aluzeita1590/gemelo-digital-aceite-oliva/README.md

# Gemelo Digital — Tanque de Almacenamiento de Aceite de Oliva

**Trabajo de Titulación — Ingeniería Civil Electrónica, UACh**  
Autor: Sebastián Araneda

---

## Descripción

Sistema de gemelo digital para un tanque prototipo de 20 L de aceite de oliva,
organizado en una arquitectura de 4 capas escalable a los tanques industriales
de 50.000 L de Las 200.

El sistema estima en tiempo real la distribución espacial de temperatura T(r,z,t),
nivel y masa del aceite, a partir de las temperaturas medidas en la pared exterior
del tanque. Los resultados se visualizan en un dashboard Grafana y un heatmap 2D
generado por el modelo.

---

## Arquitectura del sistema

**Capa 1 — Raspberry Pi `sensor` (192.168.1.106)**
- 5× DS18B20 en pared exterior (DS0–DS4), 2× DS18B20 ambiente (DS_AMB1, DS_AMB2), 1× DS18B20 tanque superior (DS_SUP), 1x DS18B20 interir (DS_INT)
- HC-SR04 (nivel), HX711 + celda de carga (masa), Display OLED
- Publica JSON por MQTT cada 10 segundos al broker en `gemelo5`
- Corre como `sensor.service` (systemd)

**Capa 2 — Raspberry Pi `gemelo5` (192.168.1.104)**
- Broker Mosquitto recibe los mensajes MQTT
- Suscriptor Python valida rangos físicos y escribe en InfluxDB bucket `gemelo`
- Corre como `suscriptor.service` (systemd)

**Capa 3 — Raspberry Pi `gemelo5`**
- Modelo 2D axisimétrico T(r,z,t) en tiempo real
- Lee temperaturas de pared desde InfluxDB, estima la distribución interior del fluido
- Sirve heatmap PNG en puerto 5000 via Flask
- Corre como `modelo.service` (systemd)

**Capa 4 — Raspberry Pi `gemelo5`**
- Dashboard Grafana conectado a InfluxDB
- Kiosco en monitor conectado a la Pi 5

> La Raspberry Pi `gemelo5` es el servidor provisional.
> La migración a servidor de la UACh (con Docker) está planificada.

---

## Hardware (Prototipo)

| Componente | Función | Capa |
|---|---|---|
| Raspberry Pi Zero 2 W (`sensor`) | Adquisición de datos | 1 |
| Raspberry Pi 5 (`gemelo5`) | Servidor provisional | 2, 3, 4 |
| 5× DS18B20 (DS0–DS4) | Temperatura pared exterior (0–30 cm) | 1 |
| 2× DS18B20 (DS_AMB1, DS_AMB2) | Temperatura ambiente (promediadas) | 1 |
| 1× DS18B20 (DS_SUP) | Temperatura fluido tanque superior | 1 |
| 1× DS18B20 (DS_INT) | Temperatura interior del fluido — encapsulado sumergible, posicionado en r=0, z=20.1 cm | 1 |
| HC-SR04 | Nivel ultrasónico | 1 |
| HX711 + celda de carga | Masa | 1 |
| Display OLED 128×64 I2C | Visualización local | 1 |
| 2× YF-S021 | Caudal y volumen acumulado (entrada y salida) | 1 |

---

## Estructura del repositorio

```
gemelo-digital-aceite-oliva/
├── config.py                          # Configuración central (único lugar para cambiar parámetros)
├── .env                               # Token InfluxDB — (ver .env.example)
├── .env.example                       # Plantilla del .env
│
├── capa1_sensor/
│   ├── sensor.py                      # Script en producción — RPi Zero 2W
│   └── calibrar_flujo.py              # Calibración de sensores YF-S021
│
├── capa2_adquisicion/
│   ├── suscriptor.py                  # Script en producción — RPi 5
│   └── telegraf.conf                  # Pipeline alternativo (Telegraf)
│
├── capa3_modelo/
│   ├── modelo.py                      # Script en producción — RPi 5
│   ├── calibrar_h_ext.py              # Calibración offline del coeficiente h_ext
│   ├── resultados_calibracion/        # Gráficas generadas por calibrar_h_ext.py
│   ├── tanque_modelo_2D_v2.py         # Referencia — modelo standalone v2.1
│   └── tanque_modelo_2D_v3.py         # Referencia — modelo standalone v3.0
│
└── docker/
    ├── docker-compose.yml             # Orquestación (preparado, pendiente de despliegue)
    ├── grafana/
    │   └── telegraf-dashboard.json    # Dashboard Grafana importable — pipeline Telegraf
    ├── modelo/
    │   ├── Dockerfile                 # Imagen del modelo (usa capa3_modelo/modelo.py)
    │   └── requirements.txt
    ├── suscriptor/
    │   ├── Dockerfile                 # Imagen del suscriptor
    │   └── requirements.txt
    └── mosquitto/
        └── config/mosquitto.conf
```

---

## Configuración centralizada

Todos los parámetros del sistema están en **`config.py`** en la raíz del repositorio.
No es necesario modificar los scripts para cambiar IPs, topics, IDs de sensores o parámetros del modelo.

```python
# Ejemplos de parámetros en config.py
MQTT_BROKER_SENSOR = "192.168.1.104"   # IP del gemelo (usado por sensor)
MODELO_IC_DEFAULT  = "t_sup"           # Condición inicial al arrancar: "t_sup" | "sensores"
MODELO_ALPHA_K     = 0.6               # Ganancia asimilación de datos
```

```bash
# .env
INFLUX_TOKEN=your_influxdb_token_here
```

Crear a partir de la plantilla:
```bash
cp .env.example .env
# editar .env con el token real
```

En producción, systemd lo carga via `EnvironmentFile=/home/sebar/.env` en el override de cada servicio.
En Docker, lo inyecta `env_file: ../.env` en el `docker-compose.yml`.

---

## Modelo termofísico (Capa 3)

El modelo resuelve la **ecuación de calor en coordenadas cilíndricas** para un fluido estático:

```
ρ(T)·Cp·∂T/∂t = k·[1/r·∂/∂r(r·∂T/∂r) + ∂²T/∂z²]
```

A partir de las temperaturas medidas en la pared (DS0–DS4), estima T(r,z) en el interior del fluido.
En cada ciclo los nodos de pared se corrigen hacia las mediciones reales (asimilación de datos).

### Condiciones de contorno

| Borde | Condición |
|---|---|
| r = 0 | Simetría axial (L'Hôpital) |
| r = R | Robin + corrección por asimilación de datos (DS0–DS4) |
| z = 0 | Fondo adiabático |
| z = H | Superficie libre adiabática |

### Parámetros del modelo

| Parámetro | Valor | Descripción |
|---|---|---|
| Nr × Nz | 15 × 20 | Nodos radiales × axiales |
| dt | ≤ 30 s | Paso temporal (Von Neumann estable) |
| h_ext | 5.0 W/(m²·°C) | Convección exterior — pendiente calibración |
| alpha_K | 0.6 | Ganancia asimilación de datos |
| IC default | `t_sup` | Condición inicial al arrancar el servicio |
| `TANQUE_PARED_ESPESOR_M` | 0.003 m | Espesor de pared — prototipo HDPE 3 mm |
| `TANQUE_PARED_K` | 0.45 W/(m·°C) | Conductividad pared — HDPE (acero inox: 16) |

La resistencia térmica de la pared se incorpora en la condición Robin mediante el coeficiente global `U`:

```
1/U = e_pared/k_pared + 1/h_ext
```

Para el tanque industrial (acero inoxidable) cambiar en `config.py`:
```python
TANQUE_PARED_ESPESOR_M = 0.005   # [m]
TANQUE_PARED_K         = 16.0    # [W/(m·°C)]
```

### Propiedades del aceite (Ribeiro et al. 2017, Fasina y Colley 2008)

- ρ(T) = 912.66 − 0.0803·T [kg/m³] — densidad variable
- Cp = 1970 J/(kg·°C)
- k = 0.17 W/(m·°C)
- Válido para T ∈ [10°C, 40°C]

### Propiedades del agua (valores estándar a 20°C)

- ρ(T) = 998.2 − 0.0975·T [kg/m³] — densidad variable (linealización local)
- Cp = 4182 J/(kg·°C)
- k = 0.598 W/(m·°C)

El fluido activo se selecciona en tiempo real con el comando MQTT `fluido/aceite` o `fluido/agua` (ver sección Comandos MQTT). Al cambiar de fluido el modelo recalcula el paso temporal `dt` para mantener la estabilidad de Von Neumann.

La selección se persiste en `capa3_modelo/.fluido_estado.json` (no versionado) cada vez que se recibe el comando. Al arrancar, `modelo.py` restaura el último fluido guardado en vez de usar siempre `MODELO_FLUIDO_DEFAULT` de `config.py` — así un reinicio del servicio (crash, `git pull`, reboot) no revierte silenciosamente una prueba en curso con agua al default de aceite.

### Versiones de referencia (archivos standalone)

| Versión | Grilla | Laplaciano | Archivo |
|---|---|---|---|
| v2.1 | Nr=3, Nz=7 | Loops Python | `tanque_modelo_2D_v2.py` |
| v3.0 | Nr=15, Nz=20 | Vectorizado NumPy (~50× más rápido) | `tanque_modelo_2D_v3.py` |

### Geometría real del tanque

El tanque prototipo no es un cilindro perfecto — el radio interno crece linealmente desde la base hasta la tapa (frustum cónico). El solver térmico usa el radio nominal `TANQUE_R_M` como aproximación, pero el cálculo de volumen y masa usa la geometría real medida:

| Altura | Diámetro medido | Radio |
|---|---|---|
| 3.8 cm (base) | 26.6 cm | 0.133 m |
| 19.0 cm (mitad) | 27.8 cm | 0.139 m |
| 38.0 cm (tapa) | 28.9 cm | 0.1445 m |

La altura total medida es **38.2 cm** (`TANQUE_H_M = 0.382` en `config.py`), usada tanto por el modelo como por el HC-SR04 para calcular el nivel.

El radio real `R(z)` se interpola linealmente entre estos puntos mediante `TANQUE_R_MEDICIONES_Z_M` y `TANQUE_R_MEDICIONES_R_M` en `config.py`.

### Cálculo de volumen y masa

En cada ciclo el modelo estima el volumen y la masa del fluido usando tres métodos complementarios:

**V_nivel** — desde el sensor HC-SR04, integrando la sección real A(z) = π·R(z)²:
```
V_nivel = Σ π·R(z_j)²·dz   para z_j ≤ h_medido
```

**V_modelo / M_modelo** — integración nodo a nodo del campo de densidad ρ(r,z):
```
dV(i,j) = 2π·r_local·dr_j·dz      (anillo)
dV(0,j) = π·(dr_j/2)²·dz          (eje central)
dM(i,j) = ρ(i,j)·dV(i,j)
```
Donde `r_local = i·dr_j` y `dr_j = R(z_j)/(Nr-1)` usan el radio real en cada altura.

**M_HX711** — masa medida directamente por la celda de carga.

**V_balance** — balance de masa usando los sensores de flujo como referencia independiente:
```
V_balance(t) = V_nivel(t₀) + ΔV_entrada(t) − ΔV_salida(t)
```
Donde `t₀` es el instante de arranque del modelo y `ΔV` es el volumen acumulado desde ese momento según cada YF-S021. Sirve como validación cruzada entre el HC-SR04 y los sensores de flujo.

Los resultados se escriben en InfluxDB como measurement `volumen_masa` cada 60 segundos con campos `V_nivel_L`, `V_modelo_L`, `V_balance_L`, `M_hx711_kg` y `M_modelo_kg`. También se muestran en el heatmap como cuadro de texto en la esquina inferior izquierda.

### Validación interior del modelo

El sensor **DS_INT** (DS18B20 con encapsulado sumergible) está posicionado en el interior del fluido en r=0 (eje central), z=20.1 cm, coincidiendo exactamente con el nodo del modelo `T[0, Nz//2]` (z[10] con H=38.2 cm, Nz=20, dz=2.01 cm).

En cada ciclo de 60 segundos el modelo escribe el measurement `validacion_interior` en InfluxDB con los campos:

| Campo | Descripción |
|---|---|
| `T_medida_C` | Temperatura medida por DS_INT [°C] |
| `T_modelo_C` | Temperatura estimada por el modelo en nodo (r=0, z≈20.1 cm) [°C] |
| `error_C` | Diferencia T_modelo − T_medida [°C] |
| `nodo_z_cm` | Posición axial del nodo de comparación [cm] |

Además de la variante nominal (`alpha_K`), el mismo punto incluye `T_alta_C`/`error_alta_C` (α=0,80), `T_baja_C`/`error_baja_C` (α=0,20) y `T_libre_C`/`error_libre_C` (α=0, sin asimilación) — variantes con heatmap propio (`/heatmap_alta`, `/heatmap_baja`, `/heatmap_libre`) que corren en paralelo para comparación. También se agregaron tres variantes exploratorias sin heatmap propio, solo para acotar el óptimo de `alpha_K` encontrado en el Capítulo 5 de la tesis (vértice≈0,36): `T_a30_C`/`error_a30_C` (α=0,30), `T_a35_C`/`error_a35_C` (α=0,35) y `T_a40_C`/`error_a40_C` (α=0,40).

El heatmap muestra un **punto cian** en la posición del sensor y los valores T int med / T int mod / Error int en el cuadro inferior.

Con la corrección geométrica, la diferencia entre V_nivel y V_modelo se redujo de 14% a ~7%.

#### Métricas de error: MAE y RMSE

Las métricas se calculan sobre la ventana temporal seleccionada en Grafana mediante queries Flux al measurement `validacion_interior`.

**Definiciones:**

$$\text{MAE} = \frac{1}{N} \sum_{k=1}^{N} |e_k|$$

$$\text{RMSE} = \sqrt{\frac{1}{N} \sum_{k=1}^{N} e_k^2}$$

donde $e_k = T_{\text{modelo},k} - T_{\text{medida},k}$ es el error en el instante $k$ y $N$ es el número de muestras en la ventana. El RMSE penaliza más los errores grandes (por el cuadrado), por lo que RMSE ≥ MAE siempre. La hipótesis de validación de la tesis establece RMSE < 1 °C.

**Query MAE (Flux):**
```flux
import "math"
from(bucket: "gemelo")
  |> range(start: v.timeRangeStart, stop: v.timeRangeStop)
  |> filter(fn: (r) => r._measurement == "validacion_interior")
  |> filter(fn: (r) => r._field == "error_C")
  |> map(fn: (r) => ({r with _value: math.abs(x: r._value)}))
  |> mean()
  |> yield(name: "MAE")
```

**Query RMSE (Flux):**
```flux
import "math"
from(bucket: "gemelo")
  |> range(start: v.timeRangeStart, stop: v.timeRangeStop)
  |> filter(fn: (r) => r._measurement == "validacion_interior")
  |> filter(fn: (r) => r._field == "error_C")
  |> map(fn: (r) => ({r with _value: r._value * r._value}))
  |> mean()
  |> map(fn: (r) => ({r with _value: math.sqrt(x: r._value)}))
  |> yield(name: "RMSE")
```

Estos queries están implementados en el dashboard **Gemelo Digital — Validación Interior** (`docker/grafana/validacion-interior-dashboard.json`), que se puede importar en Grafana desde Dashboards → Import → Upload JSON file.

> **Nota de arranque:** al reiniciar el sistema, siempre detener/reiniciar primero `sensor.service` y esperar ~30 segundos antes de reiniciar `modelo.service`. Si ambos se reinician simultáneamente, el sensor resetea sus contadores de volumen a 0 pero InfluxDB aún conserva los valores anteriores — esto hace que V_balance calcule un delta incorrecto al arrancar.

### Visualización del heatmap

El heatmap en `http://192.168.1.104:5000/heatmap` muestra:
- **Mapa de color** `plasma` con la distribución T(r,z)
- **Barra derecha** — escala de temperatura [°C]
- **Barra izquierda** — escala de densidad ρ [kg/m³] (colormap `plasma_r`)
- **Punto cian** — posición del sensor DS_INT en el interior del fluido (r=0, z≈20 cm)
- **Cuadro inferior** — valores de volumen, masa y validación interior (T int med / T int mod / Error int) en tiempo real

### Limitación conocida

Ra ≈ 1.4×10⁶ indica que la convección natural es significativa. El modelo asume fluido estático (conducción pura). Incorporar convección natural queda propuesto como trabajo futuro.

---

## Configuración de red

| Dispositivo | IP | Red |
|---|---|---|
| Raspberry `sensor` | 192.168.1.106 | wifi_control.iee |
| Raspberry `gemelo5` | 192.168.1.104 | wifi_control.iee |

| Servicio | URL |
|---|-----|
| Grafana dashboard | http://192.168.1.104:3000 |
| Heatmap modelo | http://192.168.1.104:5000/heatmap |
| InfluxDB | http://192.168.1.104:8086 |

---

## Pines físicos (Raspberry Pi Zero 2 W)

| Sensor | Pin físico | GPIO BCM |
|---|---|---|
| DS18B20 DATA (todos) | 7 | GPIO 4 |
| HC-SR04 TRIG | 18 | GPIO 24 |
| HC-SR04 ECHO | 22 | GPIO 25 |
| HX711 DT | 21 | GPIO 9 |
| HX711 SCK | 23 | GPIO 11 |
| OLED SDA | 3 | GPIO 2 |
| OLED SCL | 5 | GPIO 3 |
| Relé bomba (IN) | 40 | GPIO 21 |
| YF-S021 entrada | 13 | GPIO 27 |
| YF-S021 salida  | 15 | GPIO 22 |

---

## Despliegue en producción (systemd)

Los scripts corren como servicios systemd en sus respectivas RPis.

### Rutas en producción

Ambas RPis tienen el repositorio clonado en `~/gemelo-digital-aceite-oliva/`. Los servicios systemd apuntan directamente a esas rutas.

| Script | Ruta en RPi |
|---|---|
| `sensor.py` | `/home/sebar/gemelo-digital-aceite-oliva/capa1_sensor/sensor.py` (RPi Zero) |
| `suscriptor.py` | `/home/sebar/gemelo-digital-aceite-oliva/capa2_adquisicion/suscriptor.py` (RPi 5) |
| `modelo.py` | `/home/sebar/gemelo-digital-aceite-oliva/capa3_modelo/modelo.py` (RPi 5) |
| `config.py` | `/home/sebar/gemelo-digital-aceite-oliva/config.py` (ambas RPis) |
| `.env` | `/home/sebar/.env` (RPi 5) |

## Monitoreo de servicios

### Ver estado

```bash
sudo systemctl status sensor        # RPi Zero
sudo systemctl status suscriptor    # RPi 5
sudo systemctl status modelo        # RPi 5
sudo systemctl status telegraf      # RPi 5
```

### Ver logs en tiempo real

```bash
sudo journalctl -u sensor -f
sudo journalctl -u suscriptor -f
sudo journalctl -u modelo -f
sudo journalctl -u telegraf -f
```

### Reiniciar un servicio

```bash
sudo systemctl restart modelo
```

### Ver últimas líneas del log

```bash
sudo journalctl -u modelo -n 50
```

---

## Pipeline de datos

Existen dos pipelines paralelos activos que escriben en buckets separados de InfluxDB:

### Pipeline A — Suscriptor Python (`gemelo`)

```
Sensor → MQTT → suscriptor.py → InfluxDB (bucket: gemelo)
                                        ↑
modelo.py ──────────────────────────────┘  (escribe directo)
```

- Valida rangos físicos antes de escribir (descarta lecturas fuera de rango)
- Normaliza los datos en measurements separados: `temperatura`, `nivel`, `masa`, `flujo`, `bomba`
- El modelo termofísico escribe sus resultados (`temperatura_modelo`, `modelo_estado`) **directamente** en este bucket, sin pasar por MQTT
- Corre como `suscriptor.service` (systemd)
- **Dashboard Grafana principal** — incluye heatmap y datos del modelo

### Pipeline B — Telegraf (`gemelo_telegraf`)

```
Sensor → MQTT → Telegraf → InfluxDB (bucket: gemelo_telegraf)

modelo.py → InfluxDB (gemelo)   ← Telegraf NO tiene acceso
```

- Sin validación de rangos físicos
- Todos los campos en un único measurement: `mqtt_consumer`
- También recolecta métricas del sistema de la RPi 5: `cpu`, `mem`, `disk`, `temp`
- Configuración: `capa2_adquisicion/telegraf.conf` → copiado en `/etc/telegraf/telegraf.conf`
- Corre como `telegraf.service` (systemd)
- **Dashboard Grafana secundario** — datos del sensor + métricas del sistema RPi 5
- Dashboard importable disponible en `docker/grafana/telegraf-dashboard.json` (Grafana → Dashboards → Import)

### ¿Por qué dos dashboards?

El modelo termofísico escribe sus resultados directamente en InfluxDB (bucket `gemelo`), **no publica por MQTT**. Por lo tanto Telegraf nunca los ve y el dashboard de Telegraf no puede mostrar el heatmap ni los datos del modelo. Ambos pipelines son complementarios:

| | `gemelo` | `gemelo_telegraf` |
|---|---|---|
| Datos del sensor | ✓ (validados) | ✓ (sin validar) |
| Datos del modelo T(r,z) | ✓ | ✗ |
| Heatmap | ✓ | ✗ |
| Métricas sistema RPi 5 | ✗ | ✓ |

---

### Robustez ante cortes de Wi-Fi

`sensor.py` publica cada lectura con `qos=1` y una cola de reconexión acotada a
`config.MQTT_COLA_MAX_MENSAJES` (8640 mensajes = 24 h de lecturas, ~5 MB en RAM). Si se
corta el enlace entre el nodo `sensor` y el broker, paho-mqtt retiene los mensajes en
memoria y los reenvía automáticamente al reconectar (`reconnect_delay_set`, 1–30 s de
backoff) — antes se usaba QoS 0 y esas lecturas se descartaban sin más. El tope evita que
un corte anormalmente largo (días) haga crecer la cola sin límite; si se llena, paho
descarta el mensaje más viejo, no el proceso. El peor corte real medido en el período de
validación de cap5 fue de 47,5 min (~285 mensajes, ~180 KB) — muy por debajo del tope.

Esto solo cubre el proceso vivo: si `sensor.service` o la RPi se reinician durante el
corte, la cola en memoria se pierde igual (no hay persistencia en disco). El payload
incluye `ts_epoch` (hora real de la medición, `time.time()`), que `suscriptor.py` usa para
timestampear el punto en InfluxDB en vez de la hora de llegada — así una lectura reenviada
con retraso por la cola no queda mal ubicada en el tiempo.

---

## Comandos MQTT

### Control del sensor (topic: `tanque/cmd`)

```bash
# Rehacer tara de la celda de carga (tanque vacío)
mosquitto_pub -h 192.168.1.104 -t tanque/cmd -m "tara"

# Encender bomba manualmente (se mantiene hasta bomba/off)
mosquitto_pub -h 192.168.1.104 -t tanque/cmd -m "bomba/on"

# Apagar bomba
mosquitto_pub -h 192.168.1.104 -t tanque/cmd -m "bomba/off"

# Llenado automático: enciende 5 min 20 seg → apaga → notifica al modelo (inicio/sup)
mosquitto_pub -h 192.168.1.104 -t tanque/cmd -m "bomba/llenar"
```

### Control del modelo (topic: `modelo/cmd`)

```bash
# Reiniciar con temperatura del tanque superior (condición inicial uniforme)
mosquitto_pub -h 192.168.1.104 -t modelo/cmd -m "inicio/sup"

# Reiniciar con interpolación desde sensores de pared
mosquitto_pub -h 192.168.1.104 -t modelo/cmd -m "reset"

# Cambiar fluido simulado
mosquitto_pub -h 192.168.1.104 -t modelo/cmd -m "fluido/agua"
mosquitto_pub -h 192.168.1.104 -t modelo/cmd -m "fluido/aceite"
```

---

## Sensores de flujo YF-S021

Dos sensores Hall de efecto de flujo miden el caudal y el volumen acumulado:

| Sensor | Posición | GPIO BCM | Pin físico |
|---|---|---|---|
| YF-S021 entrada | Entrada del tanque de prueba | GPIO 27 | 13 |
| YF-S021 salida  | Salida del tanque de prueba  | GPIO 22 | 15 |

Los pulsos se cuentan mediante un hilo de polling a 2 ms (500 Hz de muestreo), lo que supera con margen la frecuencia máxima del sensor (~225 Hz a caudal pleno). Se usa polling en lugar de interrupts GPIO por una incompatibilidad de `RPi.GPIO` con el kernel actual de la RPi Zero 2W (`Failed to add edge detection`).

### Parámetros

| Parámetro | Valor | Descripción |
|---|---|---|
| `FLUJO_PULSOS_POR_LITRO_ENTRADA` | 478 | Pulsos/L — sensor entrada, calibrado experimentalmente (2026-05-27) |
| `FLUJO_PULSOS_POR_LITRO_SALIDA`  | 331 | Pulsos/L — sensor salida, ajustado por balance de masa (2026-05-27, con flexible en desagüe) |

> El sensor de salida cambió de 468 → 311 (calibración volumétrica) → 331 (ajuste por balance de masa) tras instalar un flexible en la línea de desagüe que redujo el caudal. Los YF-S021 no tienen factor constante a caudales muy bajos — calibrar siempre en las condiciones reales de operación.

### Calibración

Ejecutar `capa1_sensor/calibrar_flujo.py` en la RPi con `sensor.py` detenido. El script guía 5 ensayos de 1 L y calcula el factor promedio. Actualizar `FLUJO_PULSOS_POR_LITRO_ENTRADA` o `FLUJO_PULSOS_POR_LITRO_SALIDA` en `config.py` según corresponda (cambiar `PIN` en el script entre GPIO 27 y GPIO 22).

### Datos publicados en MQTT y InfluxDB

El payload MQTT incluye los campos:

```json
{
  "flujo_entrada_lmin": 1.23,
  "flujo_salida_lmin":  0.98,
  "vol_entrada_l":      12.5,
  "vol_salida_l":       11.8
}
```

En InfluxDB se escribe el measurement `flujo` con tag `sensor = "entrada"` o `"salida"` y campos `caudal_lmin` y `volumen_l`.

---

### Flujo de trabajo para experimento de llenado

**Automático (recomendado):**
1. Enviar `bomba/llenar` → la bomba enciende 5 min 20 seg, apaga sola y notifica al modelo (`inicio/sup`)
2. Abrir válvula — el fluido entra desde el tanque superior ya a temperatura conocida
3. El modelo evoluciona desde T_sup hacia el gradiente real, corrigiéndose con los sensores de pared

**Manual:**
1. Enviar `bomba/on` → llenar el tanque superior
2. Cuando esté lleno, enviar `bomba/off`
3. Enviar `inicio/sup` al modelo para establecer la condición inicial
4. Abrir válvula

---

## Despliegue con Docker (pendiente)

### Justificación de la arquitectura actual

El sistema se desarrolló con servicios systemd directamente en la RPi 5 en lugar de Docker por razones prácticas de desarrollo:

- **Iteración rápida:** cada cambio se aplica con `git pull` + `systemctl restart` en segundos, sin reconstruir imágenes
- **Depuración directa:** logs en tiempo real sin capas de abstracción adicionales
- **Compatibilidad con hardware:** el suscriptor Python y el modelo acceden a InfluxDB local sin configuración de red entre contenedores

La migración a Docker está planificada para el despliegue en el servidor del laboratorio UACh. El `docker-compose.yml` ya está preparado en el repositorio.

### Estado actual del docker-compose.yml

| Contenedor | Estado |
|---|---|
| `mosquitto` | ✓ listo |
| `influxdb` | ✓ listo |
| `grafana` | ✓ listo |
| `modelo` | ✓ listo (usa `capa3_modelo/modelo.py` directamente) |
| `suscriptor` | ✓ listo (`docker/suscriptor/`) |

### Procedimiento de migración (cuando corresponda)

**1. Backup del InfluxDB actual (RPi 5):**
```bash
influx backup /home/sebar/influx_backup --host http://localhost:8086 --token <TOKEN>
```

**2. Apagar servicios systemd:**
```bash
sudo systemctl stop modelo suscriptor telegraf
```

**3. Levantar Docker:**
```bash
cd ~/gemelo-digital-aceite-oliva/docker
docker-compose up -d
```

**4. Restaurar datos en Docker InfluxDB:**
```bash
docker exec influxdb influx restore /backup
```

**5. Actualizar token** en `.env` con el nuevo token generado por Docker InfluxDB.

Para migrar al servidor del laboratorio.

### Requisitos

- Docker y Docker Compose instalados
- Crear `.env` con `INFLUX_TOKEN` antes de arrancar (ver `.env.example`)
- Puertos disponibles: 1883, 8086, 3000, 5000

### Arrancar el stack

```bash
cd docker
docker-compose up -d
```

### Detener

```bash
docker-compose down
```

### Variables de entorno del modelo

| Variable | Valor en Docker | Valor local |
|---|---|---|
| `INFLUX_URL` | `http://influxdb:8086` | `http://localhost:8086` |
| `MQTT_BROKER` | `mosquitto` | `localhost` |
| `INFLUX_TOKEN` | desde `.env` | desde `.env` |

### Notas

- El Dockerfile usa `capa3_modelo/modelo.py` directamente — no hay modelo duplicado
- InfluxDB se inicializa con org=`uach`, bucket=`gemelo`
- Grafana arranca con acceso anónimo habilitado
- La RPi `sensor` apunta a la IP del servidor donde corre Docker (cambiar `MQTT_BROKER_SENSOR` en `config.py`)

---

## Referencias

- Ribeiro et al. (2017). Eur. J. Lipid Sci. Technol., 119(5)
- Fasina y Colley (2008). Int. J. Food Properties, 11(4)
- Turgut et al. (2009). Int. J. Food Properties, 12(4)
- Çengel, Y.A. (2007). Transferencia de calor y masa, 3ª ed.
