aluzeita1590/gemelo-digital-aceite-oliva/capa3_modelo/resultados_modelo_2D_v3.png

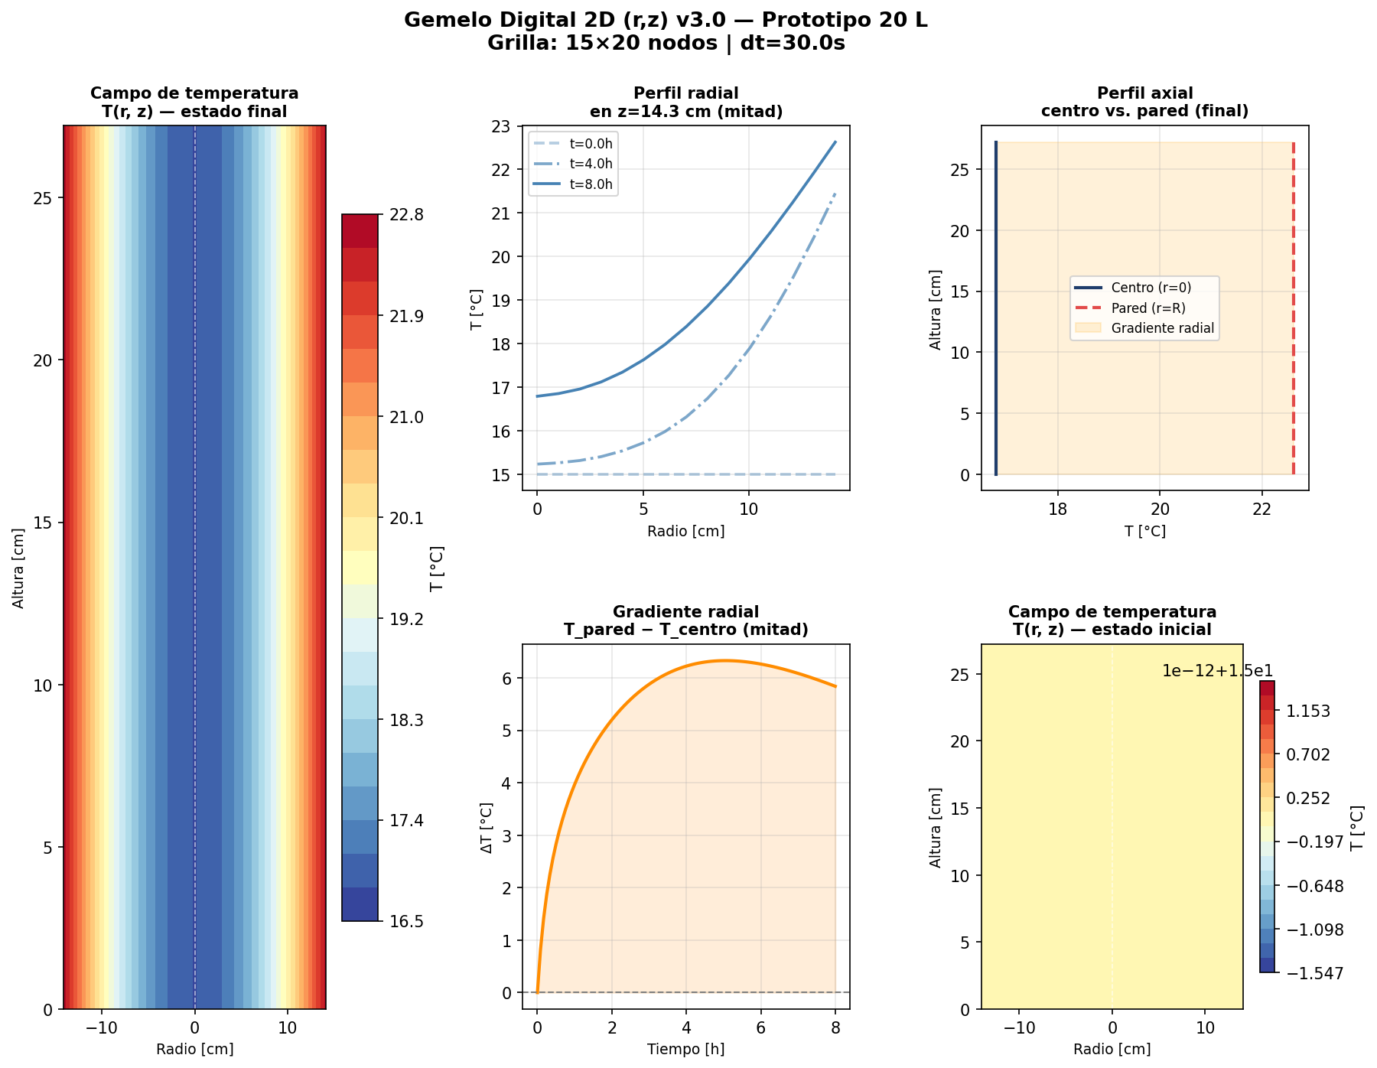
capa3_modelo/resultados_modelo_2D_v3.png
