aluzeita1590/gemelo-digital-aceite-oliva/(commit log)

2026-04-02 Agregar firmware ESP32 y modelo 2D inicial
2026-04-03 Agregar modelo termofísico 2D v3.0 con grilla refinada y Laplaciano vectorizado
    - Aumenta resolución de grilla de Nr=3,Nz=7 a Nr=15,Nz=20
    (espaciado radial pasa de ~7 cm a ~1 cm para el prototipo)
    - Reemplaza loops Python anidados en _laplaciano() por operaciones
    vectorizadas NumPy (slicing + broadcasting), aceleración ~20-100×
    - Difusividad local α_t(T) también vectorizada (sin np.vectorize)
    - Gráfico de salida guardado en directorio del script
    - Tiempo de simulación 8h: 0.03 s en laptop estándar
2026-04-03 Actualizar README con descripción completa del proyecto
    - Arquitectura en 3 capas (sensor, broker, modelo)
    - Tabla de hardware y sensores
    - Ecuación gobernante y condiciones de contorno
    - Tabla comparativa v2.1 vs v3.0
    - Estructura del repositorio y cómo ejecutar
    - Estado del proyecto con checklist
2026-04-06 Agrega sensor.py Capa 1 y suscriptor.py Capa 2
2026-04-09 Actualiza Capas 1-3: display opcional, posiciones sensores, modelo con condicion inicial dinamica
2026-04-10 Migración a Pi 5: modelo con selección de fluido MQTT, Telegraf, Grafana kiosko
2026-04-14 Agrega configuración Docker: docker-compose, Dockerfile, modelo con variables de entorno
2026-04-22 fix: interpolación scipy en condición inicial, sensores DS_AMB y DS_SUP, T_amb dinámico, detección de llenado
    [sensor.py]
2026-04-22 fix: control manual inicio/sup por MQTT, elimina detección automática de llenado
2026-04-23 docs: README actualizado con sensores DS_AMB/DS_SUP, config.py y guía de deploy
2026-04-27 feat: control de bomba por MQTT (bomba/on, bomba/off, bomba/llenar)
2026-04-28 feat: sensores de flujo YF-S021 (entrada y salida)
    - config.py: PIN_FLUJO_ENTRADA/SALIDA, FLUJO_PULSOS_POR_LITRO
    - sensor.py: polling thread 2ms en lugar de GPIO interrupts (fix RPi.GPIO/kernel),
    leer_flujo() con caudal L/min y volumen acumulado L, campos en payload MQTT
    - suscriptor.py: escribe measurement 'flujo' en InfluxDB (caudal_lmin, volumen_l)
    - README: sección sensores de flujo con calibración y queries Grafana
    [config.py, sensor.py]
2026-04-30 calibrar sensor flujo entra y salida
2026-05-08 agregar resistencias térmicas de pared configurables
2026-05-08 calibrar flujo entrada/salida y agregar resistencia térmica de pared
2026-05-08 agregar estado de bomba a InfluxDB
2026-05-12 fijar escala de color del mapa de calor entre 10 y 45 °C
2026-05-12 cambiar colormap a plasma y escala dinamica para mejor contraste
2026-05-13 agregar monitoreo de servicios y calibrar_flujo.py en README
2026-05-13 agregar script de calibracion de h_ext por experimento de enfriamiento
2026-05-13 guardar graficas de calibracion con timestamp en resultados_calibracion/
2026-05-19 agregar escala de densidad al mapa de calor
2026-05-19 ajustar barra de densidad
2026-05-19 agregar calculo de volumen y masa por integracion nodal
2026-05-20 corregir error de formateo cuando masa_k es None
2026-05-20 corregir geometria del tanque: R(z) variable en calculo de volumen y masa
2026-05-20 documentar geometria real, calculo volumen/masa y visualizacion heatmap
2026-05-26 agregar balance de masa por delta de volumen acumulado de flujo
2026-05-26 recalibrar sensores de flujo: entrada 478, salida 311
2026-05-27 ajustar fator sensor salida a 331 por balnce de masa
2026-05-27 documentar balance de masa y recalibración sensores de flujo en README
    - Agrega descripción y fórmula de V_balance (balance por sensores de flujo)
    - Añade campo V_balance_L al measurement volumen_masa en InfluxDB
    - Documenta nota crítica de orden de arranque (sensor antes que modelo, ~30s)
    - Actualiza factores YF-S021: entrada 478, salida 331 (con nota historial de cambios)
2026-05-27 agregar dashboard Grafana importable para pipeline Telegraf
    JSON con 5 secciones: temperaturas DS0-DS4 + amb/sup, nivel y masa,
    caudal y volumen acumulado (YF-S021), estado bomba (state-timeline),
    y métricas del sistema RPi5: CPU, RAM, disco, temperatura CPU.
    Datasource parametrizado con ${DS_INFLUXDB} — al importar Grafana pide
    seleccionar la datasource InfluxDB apuntando al bucket gemelo_telegraf.
2026-05-28 agregar sensor DS_INT (temperatura interior del tanque)
    - config.py: DS0 cambiado a ID 00000095fc87 (sensor nuevo en base);
    DS_INT_ID = 01215cc6aad0 (antiguo DS0, encapsulado sumergible)
    - sensor.py: leer_temperatura_interior() y campo t_int en payload MQTT
    - suscriptor.py: escribe t_int en InfluxDB con tag sensor=DS_INT
2026-05-28 corregir altura del tanque: 36.6 cm → 38.2 cm (medición directa)
2026-05-28 agregar validación interior DS_INT vs modelo en nodo (r=0, z≈20cm)
    - leer_t_int(): lee DS_INT desde InfluxDB (sensor sumergible)
    - _INT_J = Nz//2: nodo axial más cercano a z=19.1 cm del sensor
    - Loop: compara T_medida vs T[0,_INT_J] cada 60s → escribe measurement
    validacion_interior con campos T_medida_C, T_modelo_C, error_C
    - Heatmap: punto cian en posición del sensor + T int med/mod/error en cuadro
2026-05-28 corregir notacion cientifica en colorbar de densidad
2026-05-29 actualizar README: DS_INT, altura 38.2cm, validación_interior, dashboard Telegraf
2026-05-29 incorporar metricas de error en README.md
2026-06-04 fix sensor nivel: filtro eco pared, fallback lecturas, ALTURA_CM=37cm; modelo: fallback nivel 10min; agregar dashboard validacion interior
    [config.py, sensor.py]
2026-06-05 revertir: volver a versión pre-firltro de diagnóstico
    [config.py, sensor.py]
2026-06-05 fix nivel: restaurar filtro eco pared + limitar fallback prévio a 18 ciclos
    [config.py, sensor.py]
2026-06-05 fix:config: ALTURA_CM=37.2cm y TANQUE_H_M=0.372m (mediciones corregidas)
    [config.py]
2026-06-08 feat modelo: agregar modelo libre (sin asimilación) para comparación
2026-06-08 feat modleo: agregar endpoint /heatmap_libre con imagen del modelo libre
2026-07-08 feat: agregar modelo baja asimilación (α=0.20) para comparación
    - config.py: MODELO_ALPHA_K_BAJA = 0.20
    - modelo.py: T_baja con paso_tiempo, asimilación α=0.20, validacion_interior
    campos T_baja_C/error_baja_C, endpoint /heatmap_baja, escribir/generar_imagen_baja
    fix: declarar T_alta y T_baja como global en on_modelo_message
    - dashboard: T_baja_C (púrpura) en series de temperatura y error,
    sección MAE/RMSE baja al final
    [config.py]
2026-07-08 feat: mostrar errores de todas las variantes en el cuadro del heatmap
    generar_imagen ahora muestra T_int para α=0.60, α=0.80, α=0.20 y α=0.00
    con su error respecto a DS_INT en el cuadro de texto superpuesto.
2026-08-25 fix: persistir fluido activo y evitar pérdida de datos por corte Wi-Fi
    - modelo.py: guarda el fluido seleccionado por MQTT en disco
    (.fluido_estado.json) y lo restaura al arrancar, en vez de volver
    siempre al default de config.py — un reinicio del servicio ya no
    revierte silenciosamente una prueba en curso con otro fluido.
    - sensor.py: publica con QoS 1 (antes QoS 0) más un tope de cola
    (config.MQTT_COLA_MAX_MENSAJES) para no perder ni acumular sin
    límite las lecturas tomadas durante un corte de Wi-Fi, y agrega
    ts_epoch con la hora real de la medición.
    - suscriptor.py: usa ts_epoch del payload para el timestamp en
    InfluxDB en vez de la hora de llegada, para que una lectur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
    [config.py, sensor.py]
2026-08-25 feat: scripts de análisis de validación y optimización de alpha_K para cap5
    - analisis_cap5.py: métricas RMSE/MAE/R² de las 4 variantes de
    asimilación contra DS_INT, figuras y tabla LaTeX para cap5.
    - optimizar_alpha_k.py: barrido continuo de alpha_K reproduciendo
    offline la física de modelo.py, para ubicar el óptimo real más
    allá de las 4 variantes fijas.
    Ambos con ventana actualizada a 2026-07-25 → 2026-08-25 (últimos 30
    días) para el reanálisis pendiente en gemelo5.
2026-08-26 feat: agregar variantes exploratorias alpha_K=0.30/0.35/0.40 - modelo.py: 3 variantes de asimilación nuevas (sin heatmap propio, solo registran T/error en validacion_interior) para acotar el óptimo d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
    [config.py]
2026-10-09 fix: calibrar h_ext=9.0 con experimento de enfriamiento natural (agua)
2026-10-09 feat: agregar comando inicio/int para fijar condición inicial desde DS_INT
